Sebasandtazz/CanaryCap/CanaryCap PCB/CanaryCap.kicad_pcb

## KiCad design CanaryCap PCB/CanaryCap.kicad_pcb (2025-11-20)

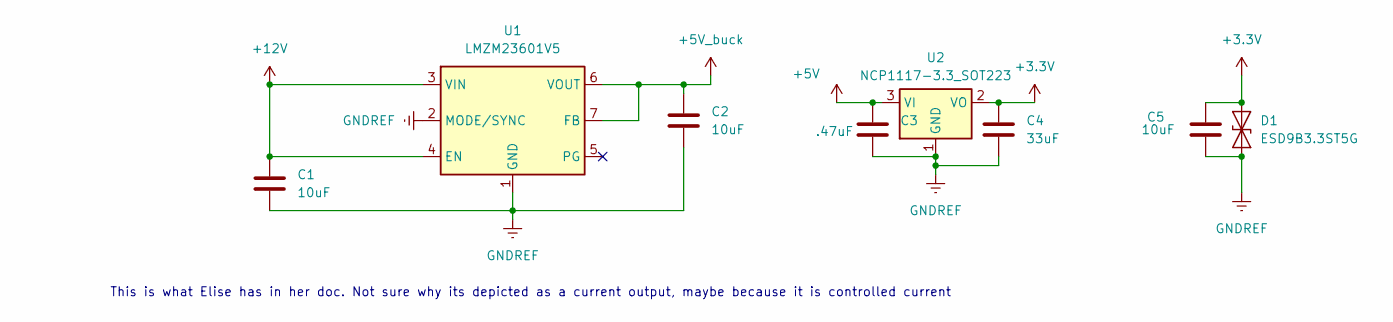
[picture p1: schematic power.kicad_sch, Power Component Schematic]

Parts:
C1, C2, C5: 10uF; C_0603_1608Metric_Pad1.08x0.95mm_HandSolder
C3: .47uF; C_0603_1608Metric_Pad1.08x0.95mm_HandSolder
C4: 33uF; C_0603_1608Metric_Pad1.08x0.95mm_HandSolder
D1: ESD9B3.3ST5G; D_SOD-923
U1: LMZM23601V5; Texas_SIL0010A_MicroSiP-10-1EP_3.8x3mm_P0.6mm_EP0.7x2.9mm_T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
U2: NCP1117-3.3_SOT223; SOT-223-3_TabPin2

Connections:
+3.3V: C4.1, C5.1, D1.2 (A2), U2.2 (VO); also elsewhere on the board
+5V: C3.1, U2.3 (VI); also elsewhere on the board
+5V_buck: C2.1, U1.6 (VOUT), U1.7 (FB); also elsewhere on the board
+12V: C1.1, U1.3 (VIN), U1.4 (EN); also elsewhere on the board
GNDREF: C1.2, C2.2, C3.2, C4.2, C5.2, D1.1 (A1), U1.1 (GND), U1.2 (MODE/SYNC), U1.11 (GND), U2.1 (GND); also elsewhere on the board

Notes on the sheet:
This is what Elise has in her doc. Not sure why its depicted as a current output, maybe because it is controlled current

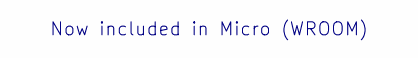
[picture p2: schematic rf.kicad_sch]

Notes on the sheet:
Now included in Micro (WROOM)

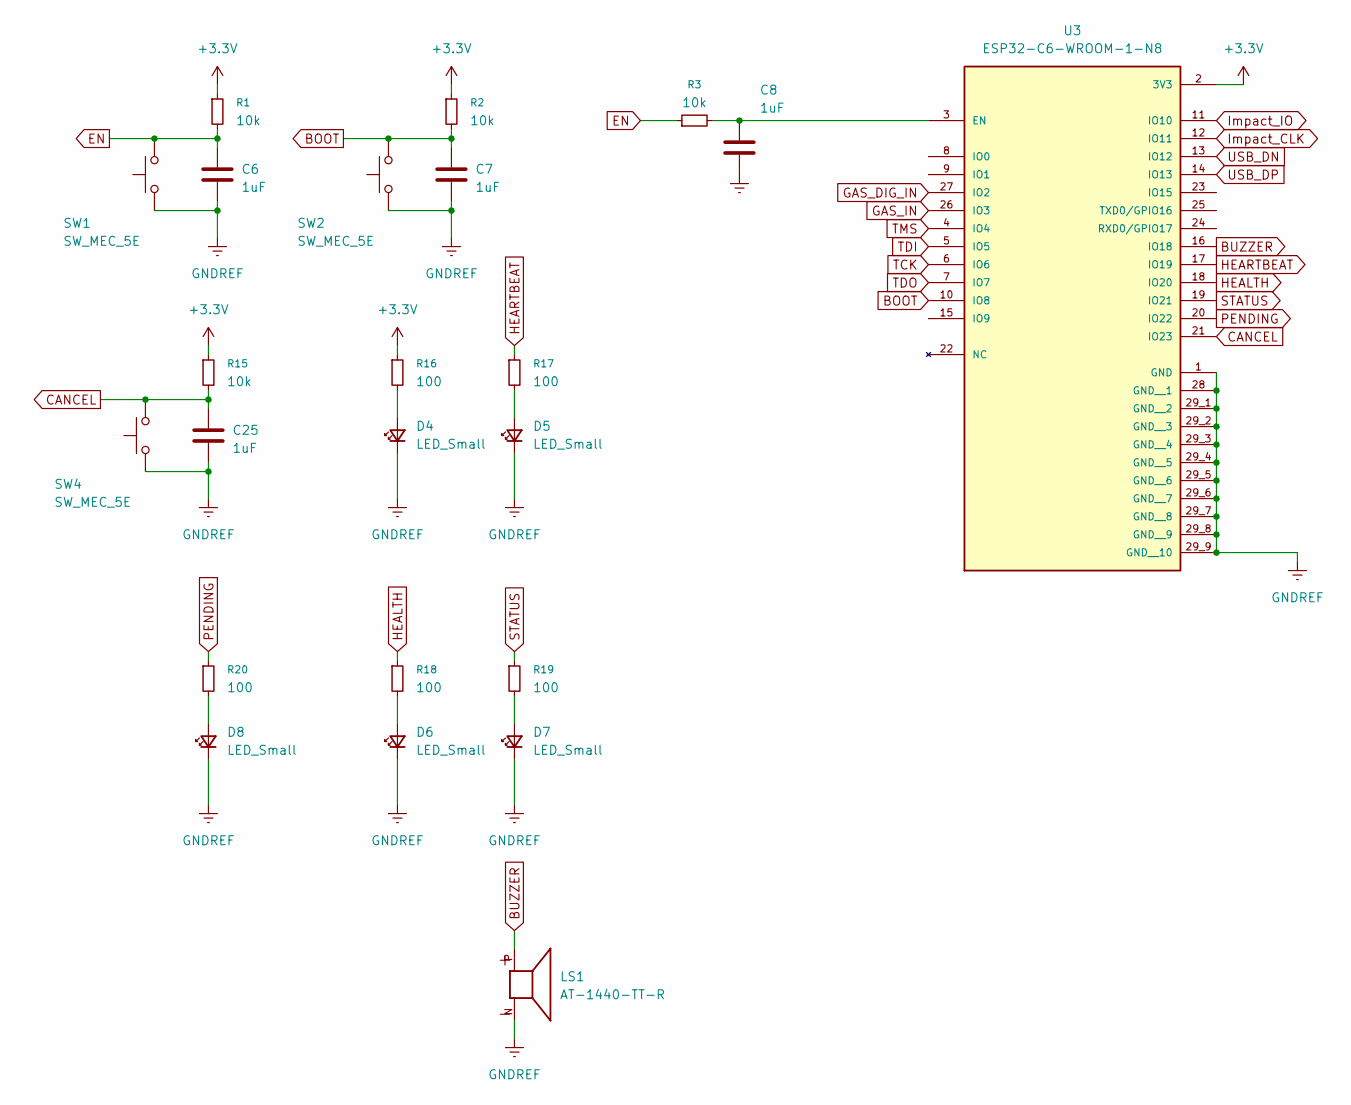
[picture p3: schematic micro.kicad_sch, Microcontroller Schematic]

Parts:
C6, C7, C8, C25: 1uF; C_0603_1608Metric_Pad1.08x0.95mm_HandSolder
D4, D5, D6, D7, D8: LED_Small; LED_0603_1608Metric_Pad1.05x0.95mm_HandSolder
LS1: AT-1440-TT-R; XDCR_AT-1440-TT-R; PARTREV 2014/07/25
R1, R2, R3, R15: 10k; R_0603_1608Metric_Pad0.98x0.95mm_HandSolder
R16, R17, R18, R19, R20: 100; R_0603_1608Metric_Pad0.98x0.95mm_HandSolder
SW1, SW2, SW4: SW_MEC_5E; SW_SPST_EVQP2_MiddlePushTravel_H2.5mm
U3: ESP32-C6-WROOM-1-N8; XCVR_ESP32-C6-WROOM-1-N8; PARTREV 1.0

Connections:
+3.3V: R1.1, R2.1, R15.1, R16.1, U3.2 (3V3); also elsewhere on the board
BOOT: C7.1, R2.2, SW2.2, U3.10 (IO8)
BUZZER: LS1.P, U3.16 (IO18)
CANCEL: C25.1, R15.2, SW4.2, U3.21 (IO23)
EN: C6.1, R1.2, R3.1, SW1.2
GAS_DIG_IN: U3.27 (IO2); also elsewhere on the board
GAS_IN: U3.26 (IO3); also elsewhere on the board
GNDREF: C6.2, C7.2, C8.2, C25.2, D4.1 (K), D5.1 (K), D6.1 (K), D7.1 (K), D8.1 (K), LS1.N, SW1.1, SW2.1, SW4.1, U3.1 (GND), U3.28 (GND__1), U3.29_1 (GND__2), U3.29_2 (GND__3), U3.29_3 (GND__4), U3.29_4 (GND__5), U3.29_5 (GND__6), U3.29_6 (GND__7), U3.29_7 (GND__8), U3.29_8 (GND__9), U3.29_9 (GND__10), U3.30_1, U3.30_2, U3.30_3, U3.30_4, U3.30_5, U3.30_6, U3.30_7, U3.30_8, U3.30_9, U3.30_10, U3.30_11, U3.30_12; also elsewhere on the board
HEALTH: R18.1, U3.18 (IO20); also elsewhere on the board
HEARTBEAT: R17.1, U3.17 (IO19); also elsewhere on the board
Impact_CLK: U3.12 (IO11); also elsewhere on the board
Impact_IO: U3.11 (IO10); also elsewhere on the board
unnamed: D4.2 (A), R16.2
unnamed: D5.2 (A), R17.2
unnamed: D6.2 (A), R18.2
unnamed: D7.2 (A), R19.2
unnamed: D8.2 (A), R20.2
unnamed: C8.1, R3.2, U3.3 (EN)
PENDING: R20.1, U3.20 (IO22); also elsewhere on the board
STATUS: R19.1, U3.19 (IO21); also elsewhere on the board
TCK: U3.6 (IO6); also elsewhere on the board
TDI: U3.5 (IO5); also elsewhere on the board
TDO: U3.7 (IO7); also elsewhere on the board
TMS: U3.4 (IO4); also elsewhere on the board
USB_DN: U3.13 (IO12); also elsewhere on the board
USB_DP: U3.14 (IO13); also elsewhere on the board

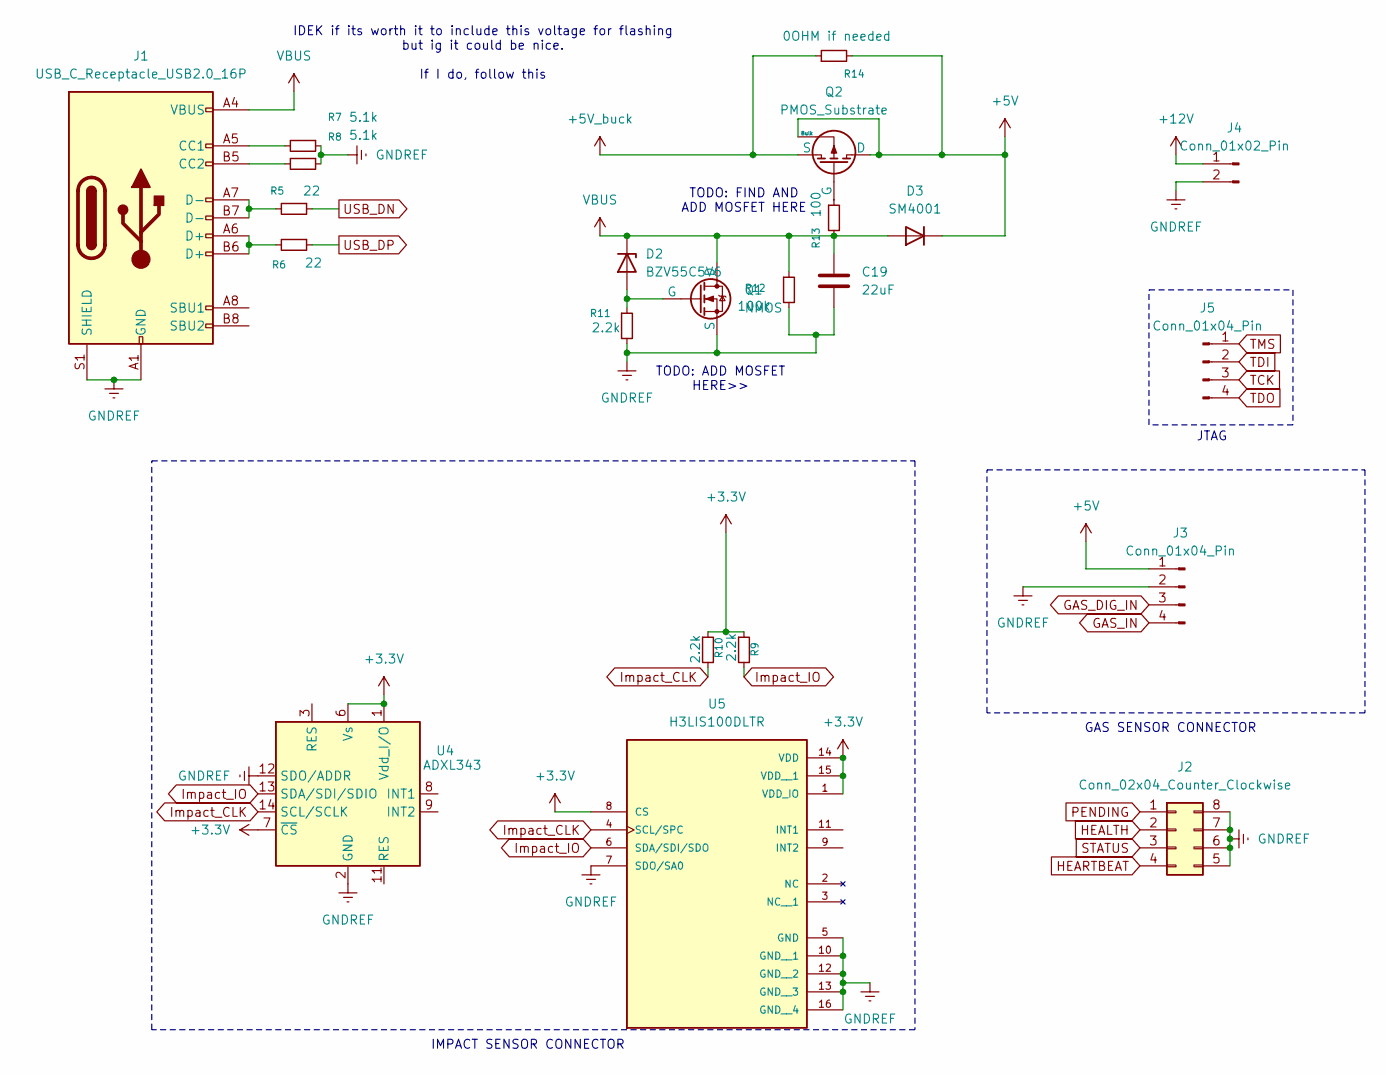
[picture p4: schematic io.kicad_sch]

Parts:
C19: 22uF; C_0603_1608Metric_Pad1.08x0.95mm_HandSolder
D2: BZV55C5V6; D_MiniMELF
D3: SM4001; D_MELF
J1: USB_C_Receptacle_USB2.0_16P; USB_C_Receptacle_G-Switch_GT-USB-7010ASV
J2: Conn_02x04_Counter_Clockwise; PinHeader_2x04_P2.54mm_Vertical
J3, J5: Conn_01x04_Pin; PinHeader_1x04_P2.54mm_Vertical
J4: Conn_01x02_Pin; PinHeader_1x02_P2.54mm_Vertical
Q1: NMOS; SOT-23
Q2: PMOS_Substrate; SOT-223
R5, R6: 22; R_0603_1608Metric_Pad0.98x0.95mm_HandSolder
R7, R8: 5.1k; R_0603_1608Metric_Pad0.98x0.95mm_HandSolder
R9, R10, R11: 2.2k; R_0603_1608Metric_Pad0.98x0.95mm_HandSolder
R12: 100k; R_0603_1608Metric_Pad0.98x0.95mm_HandSolder
R13: 100; R_0603_1608Metric_Pad0.98x0.95mm_HandSolder
R14: 0OHM if needed; R_0603_1608Metric_Pad0.98x0.95mm_HandSolder
U4: ADXL343; LGA-14_3x5mm_P0.8mm_LayoutBorder1x6y
U5: H3LIS100DLTR; PARTREV 2

Connections:
+3.3V: R9.1, R10.1, U4.1 (Vdd_I/O), U4.6 (Vs), U4.7 (~CS), U5.1 (VDD_IO), U5.8 (CS), U5.14 (VDD), U5.15 (VDD__1); also elsewhere on the board
+5V: D3.1 (K), J3.1, Q2.2 (D), Q2.4 (Bulk), R14.2; also elsewhere on the board
+5V_buck: Q2.3 (S), R14.1; also elsewhere on the board
+12V: J4.1; also elsewhere on the board
GAS_DIG_IN: J3.3; also elsewhere on the board
GAS_IN: J3.4; also elsewhere on the board
GNDREF: C19.2, J1.A1 (GND), J1.A12 (GND), J1.B1 (GND), J1.B12 (GND), J1.S1 (SHIELD), J2.5, J2.6, J2.7, J2.8, J3.2, J4.2, Q1.2 (S), R7.1, R8.1, R11.2, R12.2, U4.2 (GND), U4.4 (GND), U4.5 (GND), U4.12 (SDO/ADDR), U5.5 (GND), U5.7 (SDO/SA0), U5.10 (GND__1), U5.12 (GND__2), U5.13 (GND__3), U5.16 (GND__4); also elsewhere on the board
HEALTH: J2.2; also elsewhere on the board
HEARTBEAT: J2.4; also elsewhere on the board
Impact_CLK: R10.2, U4.14 (SCL/SCLK), U5.4 (SCL/SPC); also elsewhere on the board
Impact_IO: R9.2, U4.13 (SDA/SDI/SDIO), U5.6 (SDA/SDI/SDO); also elsewhere on the board
unnamed: D2.2 (A), Q1.1 (G), R11.1
unnamed: J1.A5 (CC1), R7.2
unnamed: J1.B5 (CC2), R8.2
unnamed: J1.A6 (D+), J1.B6 (D+), R6.2
unnamed: J1.A7 (D-), J1.B7 (D-), R5.2
unnamed: Q2.1 (G), R13.1
PENDING: J2.1; also elsewhere on the board
STATUS: J2.3; also elsewhere on the board
TCK: J5.3; also elsewhere on the board
TDI: J5.2; also elsewhere on the board
TDO: J5.4; also elsewhere on the board
TMS: J5.1; also elsewhere on the board
USB_DN: R5.1; also elsewhere on the board
USB_DP: R6.1; also elsewhere on the board
VBUS: C19.1, D2.1 (K), D3.2 (A), J1.A4 (VBUS), J1.A9 (VBUS), J1.B4 (VBUS), J1.B9 (VBUS), Q1.3 (D), R12.1, R13.2

Notes on the sheet:
TODO: FIND AND ADD MOSFET HERE
IDEK if its worth it to include this voltage for flashing but ig it could be nice. If I do, follow this
TODO: ADD MOSFET HERE>>
IMPACT SENSOR CONNECTOR
GAS SENSOR CONNECTOR
JTAG

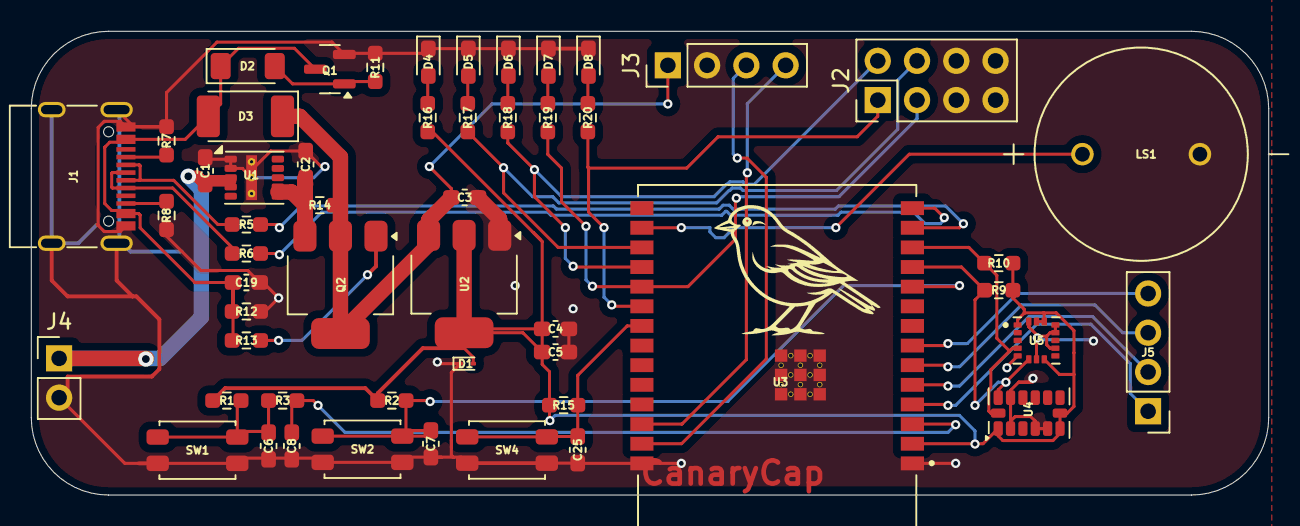
[picture p5: board CanaryCap.kicad_pcb from above]

Board: 2 copper layers, 80.0 x 30.0 mm, 53 parts (0 on the bottom side), 36 nets.
