Sebasandtazz/CanaryCap/src/main/main.c

// #include "freertos/FreeRTOS.h"
// #include "freertos/task.h"
// #include "driver/gpio.h"

#include <string.h>
#include <stdio.h>
#include "sdkconfig.h"
#include "esp_log.h"
#include "freertos/FreeRTOS.h"
#include "freertos/task.h"
#include "freertos/semphr.h"
#include "esp_adc/adc_continuous.h"

#include "esp_check.h"
#include "nvs_flash.h"
#include "ha/esp_zigbee_ha_standard.h"
#include "esp_zb_light.h"


#define EXAMPLE_ADC_UNIT                    ADC_UNIT_1
#define EXAMPLE_ADC_CONV_MODE               ADC_CONV_SINGLE_UNIT_1
#define EXAMPLE_ADC_ATTEN                   ADC_ATTEN_DB_12
#define EXAMPLE_ADC_BIT_WIDTH               SOC_ADC_DIGI_MAX_BITWIDTH

#define EXAMPLE_READ_LEN                    256

#if CONFIG_IDF_TARGET_ESP32
static adc_channel_t channel[2] = {ADC_CHANNEL_6, ADC_CHANNEL_7};
#else
static adc_channel_t channel[1] = {ADC_CHANNEL_4}; //reading off GPIO4 for ADC
#endif

#if !defined ZB_ED_ROLE
#error Define ZB_ED_ROLE in idf.py menuconfig to compile light (End Device) source code.
#endif

static adc_channel_t
static TaskHandle_t s_task_handle;
static const char *TAG = "EXAMPLE";

//configuring the processor to run at 40MHz

esp_pm_config_t pm_config = {
    .max_freq_mhz = 40,
    .min_freq_mhz = 40,
    .light_sleep_enable = true,  // Optional
};
esp_pm_configure(&pm_config);

//Configuring the ADC to run continuously at 

static bool IRAM_ATTR s_conv_done_cb(adc_continuous_handle_t handle, const adc_continuous_evt_data_t *edata, void *user_data)
{
    BaseType_t mustYield = pdFALSE;
    //Notify that ADC continuous driver has done enough number of conversions
    vTaskNotifyGiveFromISR(s_task_handle, &mustYield);

    return (mustYield == pdTRUE);
}

static void continuous_adc_init(adc_channel_t *channel, uint8_t channel_num, adc_continuous_handle_t *out_handle)
{
    adc_continuous_handle_t handle = NULL;

    adc_continuous_handle_cfg_t adc_config = {
        .max_store_buf_size = 1024,
        .conv_frame_size = EXAMPLE_READ_LEN,
    };
    ESP_ERROR_CHECK(adc_continuous_new_handle(&adc_config, &handle));

    adc_continuous_config_t dig_cfg = {
        .sample_freq_hz = 100 * 1000,
        .conv_mode = EXAMPLE_ADC_CONV_MODE,
    };

    adc_digi_pattern_config_t adc_pattern[SOC_ADC_PATT_LEN_MAX] = {0};
    dig_cfg.pattern_num = channel_num;
    for (int i = 0; i < channel_num; i++) {
        adc_pattern[i].atten = EXAMPLE_ADC_ATTEN;
        adc_pattern[i].channel = channel[i] & 0x7;
        adc_pattern[i].unit = EXAMPLE_ADC_UNIT;
        adc_pattern[i].bit_width = EXAMPLE_ADC_BIT_WIDTH;

        ESP_LOGI(TAG, "adc_pattern[%d].atten is :%"PRIx8, i, adc_pattern[i].atten);
        ESP_LOGI(TAG, "adc_pattern[%d].channel is :%"PRIx8, i, adc_pattern[i].channel);
        ESP_LOGI(TAG, "adc_pattern[%d].unit is :%"PRIx8, i, adc_pattern[i].unit);
    }
    dig_cfg.adc_pattern = adc_pattern;
    ESP_ERROR_CHECK(adc_continuous_config(handle, &dig_cfg));

    *out_handle = handle;
}

static const char *TAG = "ESP_ZB_ON_OFF_LIGHT";
/********************* Define functions **************************/
static esp_err_t deferred_driver_init(void)
{
    light_driver_init(LIGHT_DEFAULT_OFF);
    return ESP_OK;
}

static void bdb_start_top_level_commissioning_cb(uint8_t mode_mask)
{
    ESP_RETURN_ON_FALSE(esp_zb_bdb_start_top_level_commissioning(mode_mask) == ESP_OK, , TAG, "Failed to start Zigbee commissioning");
}

void esp_zb_app_signal_handler(esp_zb_app_signal_t *signal_struct)
{
    uint32_t *p_sg_p       = signal_struct->p_app_signal;
    esp_err_t err_status = signal_struct->esp_err_status;
    esp_zb_app_signal_type_t sig_type = *p_sg_p;
    switch (sig_type) {
    case ESP_ZB_ZDO_SIGNAL_SKIP_STARTUP:
        ESP_LOGI(TAG, "Initialize Zigbee stack");
        esp_zb_bdb_start_top_level_commissioning(ESP_ZB_BDB_MODE_INITIALIZATION);
        break;
    case ESP_ZB_BDB_SIGNAL_DEVICE_FIRST_START:
    case ESP_ZB_BDB_SIGNAL_DEVICE_REBOOT:
        if (err_status == ESP_OK) {
            ESP_LOGI(TAG, "Deferred driver initialization %s", deferred_driver_init() ? "failed" : "successful");
            ESP_LOGI(TAG, "Device started up in %s factory-reset mode", esp_zb_bdb_is_factory_new() ? "" : "non");
            if (esp_zb_bdb_is_factory_new()) {
                ESP_LOGI(TAG, "Start network steering");
                esp_zb_bdb_start_top_level_commissioning(ESP_ZB_BDB_MODE_NETWORK_STEERING);
            } else {
                ESP_LOGI(TAG, "Device rebooted");
            }
        } else {
            /* commissioning failed */
            ESP_LOGW(TAG, "Failed to initialize Zigbee stack (status: %s)", esp_err_to_name(err_status));
        }
        break;
    case ESP_ZB_BDB_SIGNAL_STEERING:
        if (err_status == ESP_OK) {
            esp_zb_ieee_addr_t extended_pan_id;
            esp_zb_get_extended_pan_id(extended_pan_id);
            ESP_LOGI(TAG, "Joined network successfully (Extended PAN ID: %02x:%02x:%02x:%02x:%02x:%02x:%02x:%02x, PAN ID: 0x%04hx, Channel:%d, Short Address: 0x%04hx)",
                     extended_pan_id[7], extended_pan_id[6], extended_pan_id[5], extended_pan_id[4],
                     extended_pan_id[3], extended_pan_id[2], extended_pan_id[1], extended_pan_id[0],
                     esp_zb_get_pan_id(), esp_zb_get_current_channel(), esp_zb_get_short_address());
        } else {
            ESP_LOGI(TAG, "Network steering was not successful (status: %s)", esp_err_to_name(err_status));
            esp_zb_scheduler_alarm((esp_zb_callback_t)bdb_start_top_level_commissioning_cb, ESP_ZB_BDB_MODE_NETWORK_STEERING, 1000);
        }
        break;
    default:
        ESP_LOGI(TAG, "ZDO signal: %s (0x%x), status: %s", esp_zb_zdo_signal_to_string(sig_type), sig_type,
                 esp_err_to_name(err_status));
        break;
    }
}

static esp_err_t zb_attribute_handler(const esp_zb_zcl_set_attr_value_message_t *message)
{
    esp_err_t ret = ESP_OK;
    bool light_state = 0;

    ESP_RETURN_ON_FALSE(message, ESP_FAIL, TAG, "Empty message");
    ESP_RETURN_ON_FALSE(message->info.status == ESP_ZB_ZCL_STATUS_SUCCESS, ESP_ERR_INVALID_ARG, TAG, "Received message: error status(%d)",
                        message->info.status);
    ESP_LOGI(TAG, "Received message: endpoint(%d), cluster(0x%x), attribute(0x%x), data size(%d)", message->info.dst_endpoint, message->info.cluster,
             message->attribute.id, message->attribute.data.size);
    if (message->info.dst_endpoint == HA_ESP_LIGHT_ENDPOINT) {
        if (message->info.cluster == ESP_ZB_ZCL_CLUSTER_ID_ON_OFF) {
            if (message->attribute.id == ESP_ZB_ZCL_ATTR_ON_OFF_ON_OFF_ID && message->attribute.data.type == ESP_ZB_ZCL_ATTR_TYPE_BOOL) {
                light_state = message->attribute.data.value ? *(bool *)message->attribute.data.value : light_state;
                ESP_LOGI(TAG, "Light sets to %s", light_state ? "On" : "Off");
                light_driver_set_power(light_state);
            }
        }
    }
    return ret;
}

//zigbee code


static esp_err_t zb_action_handler(esp_zb_core_action_callback_id_t callback_id, const void *message)
{
    esp_err_t ret = ESP_OK;
    switch (callback_id) {
    case ESP_ZB_CORE_SET_ATTR_VALUE_CB_ID:
        ret = zb_attribute_handler((esp_zb_zcl_set_attr_value_message_t *)message);
        break;
    default:
        ESP_LOGW(TAG, "Receive Zigbee action(0x%x) callback", callback_id);
        break;
    }
    return ret;
}

static void esp_zb_task(void *pvParameters)
{
    /* initialize Zigbee stack */
    esp_zb_cfg_t zb_nwk_cfg = ESP_ZB_ZED_CONFIG();
    esp_zb_init(&zb_nwk_cfg);
    esp_zb_on_off_light_cfg_t light_cfg = ESP_ZB_DEFAULT_ON_OFF_LIGHT_CONFIG();
    esp_zb_ep_list_t *esp_zb_on_off_light_ep = esp_zb_on_off_light_ep_create(HA_ESP_LIGHT_ENDPOINT, &light_cfg);
    zcl_basic_manufacturer_info_t info = {
        .manufacturer_name = ESP_MANUFACTURER_NAME,
        .model_identifier = ESP_MODEL_IDENTIFIER,
    };

    esp_zcl_utility_add_ep_basic_manufacturer_info(esp_zb_on_off_light_ep, HA_ESP_LIGHT_ENDPOINT, &info);
    esp_zb_device_register(esp_zb_on_off_light_ep);
    esp_zb_core_action_handler_register(zb_action_handler);
    esp_zb_set_primary_network_channel_set(ESP_ZB_PRIMARY_CHANNEL_MASK);
    ESP_ERROR_CHECK(esp_zb_start(false));
    esp_zb_stack_main_loop();
}

//Memory Storage


nvs_handle_t nvs_handle;
nvs_open("storage", NVS_READWRITE, &nvs_handle);
nvs_set_i32(nvs_handle, "impact_1", value);
nvs_commit(nvs_handle);
nvs_close(nvs_handle);

//buzzer

ledc_timer_config_t ledc_timer = {
    .speed_mode = LEDC_LOW_SPEED_MODE,
    .timer_num = LEDC_TIMER_0,
    .freq_hz = 2000,  // Buzzer freq (1-4kHz typical)
    .duty_resolution = LEDC_TIMER_10_BIT,
    .clk_cfg = LEDC_AUTO_CLK,
};
ledc_timer_config(&ledc_timer);

ledc_channel_config_t ledc_channel = {
    .channel = LEDC_CHANNEL_0,
    .duty = 512,  // 50%
    .gpio_num = GPIO_NUM_18,
    .speed_mode = LEDC_LOW_SPEED_MODE,
    .hpoint = 0,
    .timer_sel = LEDC_TIMER_0
};
ledc_channel_config(&ledc_channel);




void app_main(void)
{
    esp_zb_platform_config_t config = {
        .radio_config = ESP_ZB_DEFAULT_RADIO_CONFIG(),
        .host_config = ESP_ZB_DEFAULT_HOST_CONFIG(),
    };
    ESP_ERROR_CHECK(nvs_flash_init());
    ESP_ERROR_CHECK(esp_zb_platform_config(&config));
    xTaskCreate(esp_zb_task, "Zigbee_main", 4096, NULL, 5, NULL);

    esp_err_t ret;
    uint32_t ret_num = 0;
    uint8_t result[EXAMPLE_READ_LEN] = {0};
    memset(result, 0xcc, EXAMPLE_READ_LEN);

    s_task_handle = xTaskGetCurrentTaskHandle();

    adc_continuous_handle_t handle = NULL;
    continuous_adc_init(channel, sizeof(channel) / sizeof(adc_channel_t), &handle);

    adc_continuous_evt_cbs_t cbs = {
        .on_conv_done = s_conv_done_cb,
    };
    ESP_ERROR_CHECK(adc_continuous_register_event_callbacks(handle, &cbs, NULL));
    ESP_ERROR_CHECK(adc_continuous_start(handle));

    while (1) {

        /**
         * This is to show you the way to use the ADC continuous mode driver event callback.
         * This `ulTaskNotifyTake` will block when the data processing in the task is fast.
         * However in this example, the data processing (print) is slow, so you barely block here.
         *
         * Without using this event callback (to notify this task), you can still just call
         * `adc_continuous_read()` here in a loop, with/without a certain block timeout.
         */
        ulTaskNotifyTake(pdTRUE, portMAX_DELAY);

        while (1) {
            ret = adc_continuous_read(handle, result, EXAMPLE_READ_LEN, &ret_num, 0);
            if (ret == ESP_OK) {
                ESP_LOGI("TASK", "ret is %x, ret_num is %"PRIu32" bytes", ret, ret_num);

                adc_continuous_data_t parsed_data[ret_num / SOC_ADC_DIGI_RESULT_BYTES];
                uint32_t num_parsed_samples = 0;

                esp_err_t parse_ret = adc_continuous_parse_data(handle, result, ret_num, parsed_data, &num_parsed_samples);
                if (parse_ret == ESP_OK) {
                    for (int i = 0; i < num_parsed_samples; i++) {
                        if (parsed_data[i].valid) {
                            ESP_LOGI(TAG, "ADC%d, Channel: %d, Value: %"PRIu32,
                                     parsed_data[i].unit + 1,
                                     parsed_data[i].channel,
                                     parsed_data[i].raw_data);
                        } else {
                            ESP_LOGW(TAG, "Invalid data [ADC%d_Ch%d_%"PRIu32"]",
                                     parsed_data[i].unit + 1,
                                     parsed_data[i].channel,
                                     parsed_data[i].raw_data);
                        }
                    }
                } else {
                    ESP_LOGE(TAG, "Data parsing failed: %s", esp_err_to_name(parse_ret));
                }

                /**
                 * Because printing is slow, so every time you call `ulTaskNotifyTake`, it will immediately return.
                 * To avoid a task watchdog timeout, add a delay here. When you replace the way you process the data,
                 * usually you don't need this delay (as this task will block for a while).
                 */
                vTaskDelay(1);
            } else if (ret == ESP_ERR_TIMEOUT) {
                //We try to read `EXAMPLE_READ_LEN` until API returns timeout, which means there's no available data
                break;
            }
        }
    }

    ESP_ERROR_CHECK(adc_continuous_stop(handle));
    ESP_ERROR_CHECK(adc_continuous_deinit(handle));
}
