Sebasandtazz/CanaryCap/(commit log)

2025-08-29 Initial Commit of board files for team share
    [CanaryCap.kicad_pcb, CanaryCap.kicad_sch]
2025-08-29 Reorg structure
    [CanaryCap.kicad_pcb, CanaryCap.kicad_sch]
2025-09-18 Put very basic symbols which we plan to use into the schematics, nothing else :(
2025-09-19 Started some basic board definition and component selection DO NOT USE LAYOUT
    [CanaryCap.kicad_pcb]
2025-09-19 Deleted duplicate files
    [CanaryCap.kicad_pcb]
2025-09-30 We gotta figure out git ignore
    [CanaryCap.kicad_pcb, CanaryCap.kicad_sch, partitions.csv]
2025-09-30 Pushing for new MCU
    [CanaryCap.kicad_pcb, CanaryCap.kicad_sch]
2025-10-02 Board progress
    [CanaryCap.kicad_pcb, CanaryCap.kicad_sch, io.kicad_sch, micro.kicad_sch, power.kicad_sch]
2025-10-02 Done with ts for the night
    [CanaryCap.kicad_sch, io.kicad_sch, micro.kicad_sch, power.kicad_sch]
2025-10-06 Updated schematics for justin to work
    [CanaryCap.kicad_pcb, CanaryCap.kicad_sch, io.kicad_sch, micro.kicad_sch, partitions.csv, power.kicad_sch, rf.kicad_sch]
2025-10-07 new changes
    [io.kicad_sch, micro.kicad_sch, power.kicad_sch]
2025-10-07 lets see if this works?
    [CanaryCap.kicad_pcb]
2025-10-07 PCB layout started
    [CanaryCap.kicad_pcb, CanaryCap.kicad_sch, power.kicad_sch]
2025-10-07 Deleted windows blink
    [CanaryCap.kicad_pcb, CanaryCap.kicad_sch, io.kicad_sch, micro.kicad_sch, power.kicad_sch, rf.kicad_sch]
2025-10-08 Added todo
    [CanaryCap.kicad_sch, io.kicad_sch, micro.kicad_sch, power.kicad_sch, rf.kicad_sch]
2025-10-09 FIXED IT MF
    [CanaryCap.kicad_pcb, CanaryCap.kicad_sch, io.kicad_sch, micro.kicad_sch, power.kicad_sch, rf.kicad_sch]
2025-10-10 Laid out more
    [CanaryCap.kicad_pcb]
2025-10-13 Finished level for packaging
    [micro.kicad_sch, rf.kicad_sch]
2025-10-21 bruh bruh bruh
    [CanaryCap.kicad_pcb]
2025-10-21 Added my files
    [partitions.csv]
2025-10-23 Me phinks I did it
    [micro.kicad_sch]
2025-10-30 my stuff - justin
    Git Ignore - sebastian
    [partitions.csv]
2025-11-18 All individual tasks work (i2c, adc, and zigbee)
    when in doubt, restore.
2025-11-20 Capcb updates
    [CanaryCap.kicad_pcb, io.kicad_sch, micro.kicad_sch, power.kicad_sch]
